PaulBichl/vibepcb-smu/boards/smu-front/hardware/smu-front-bottom.png

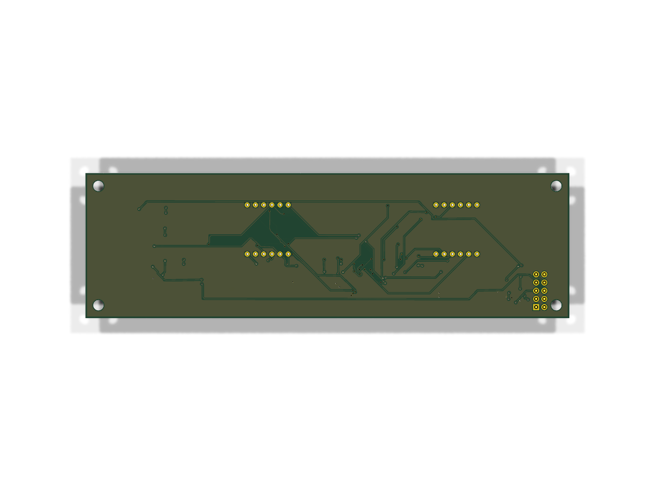
boards/smu-front/hardware/smu-front-bottom.png
