PaulBichl/vibepcb-smu/boards/smu-front/hardware/smu-front-layout-back.png

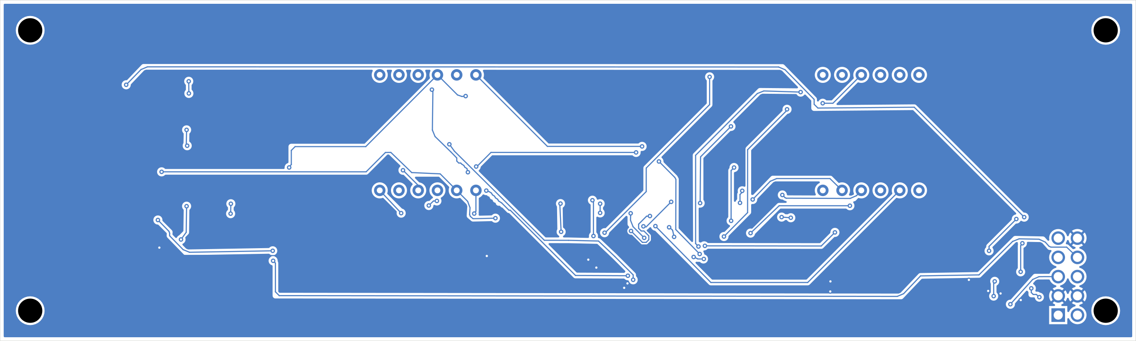
boards/smu-front/hardware/smu-front-layout-back.png
