PaulBichl/vibepcb-smu/boards/smu-front/hardware/smu-front-layout-front.png

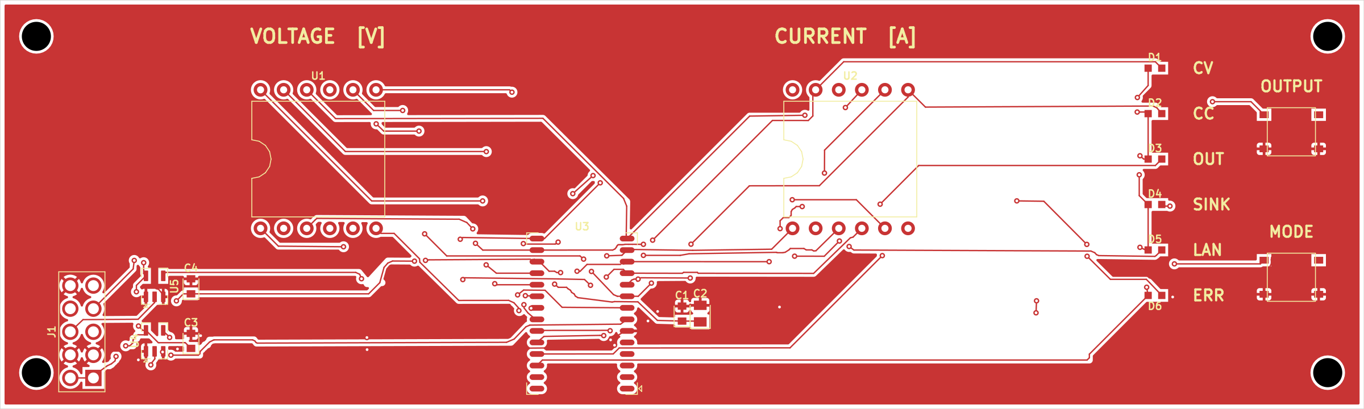
boards/smu-front/hardware/smu-front-layout-front.png
