PaulBichl/vibepcb-smu/boards/smu-main/hardware/smu-main-bottom.png

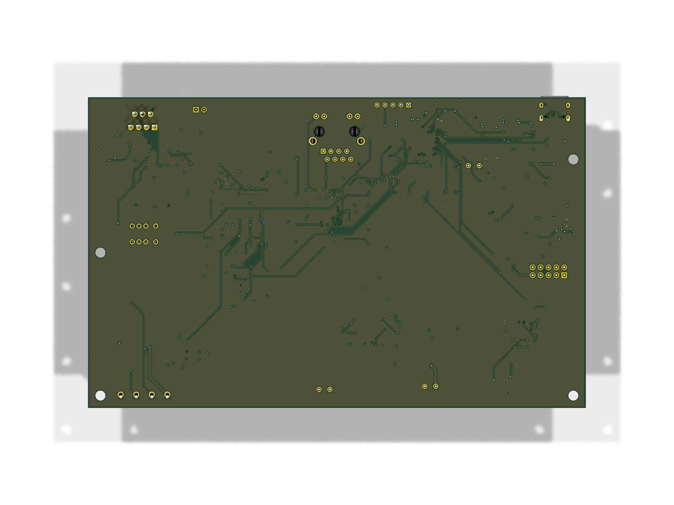
boards/smu-main/hardware/smu-main-bottom.png
