PaulBichl/vibepcb-smu/boards/smu-main/hardware/smu-main-layout-back.png

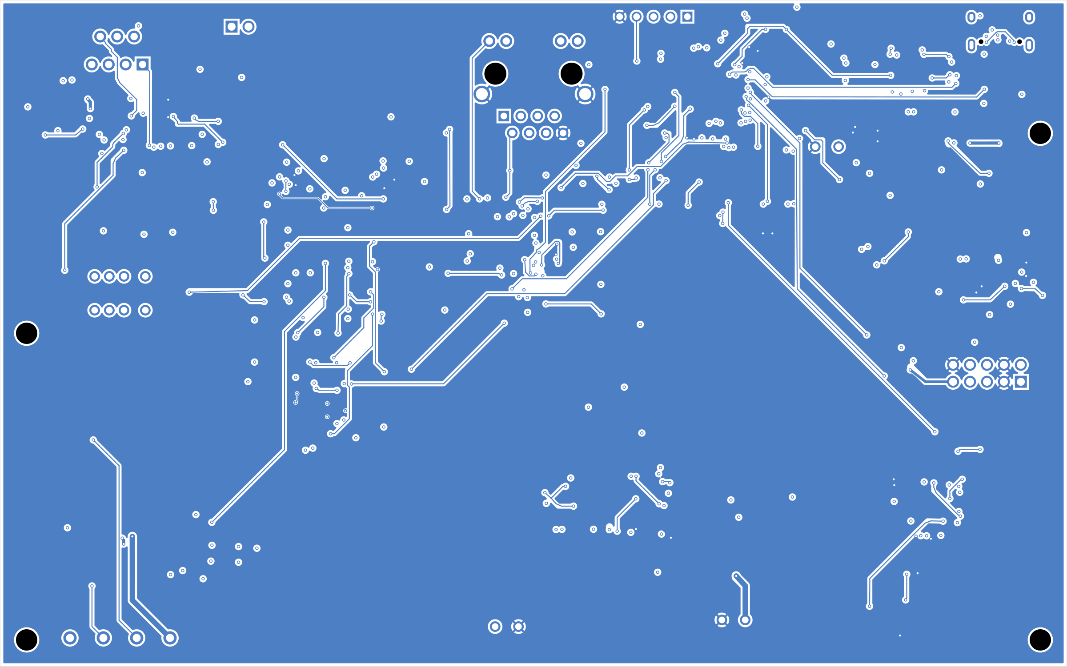
boards/smu-main/hardware/smu-main-layout-back.png
