PaulBichl/vibepcb-smu/boards/smu-main/hardware/smu-main-layout-front.png

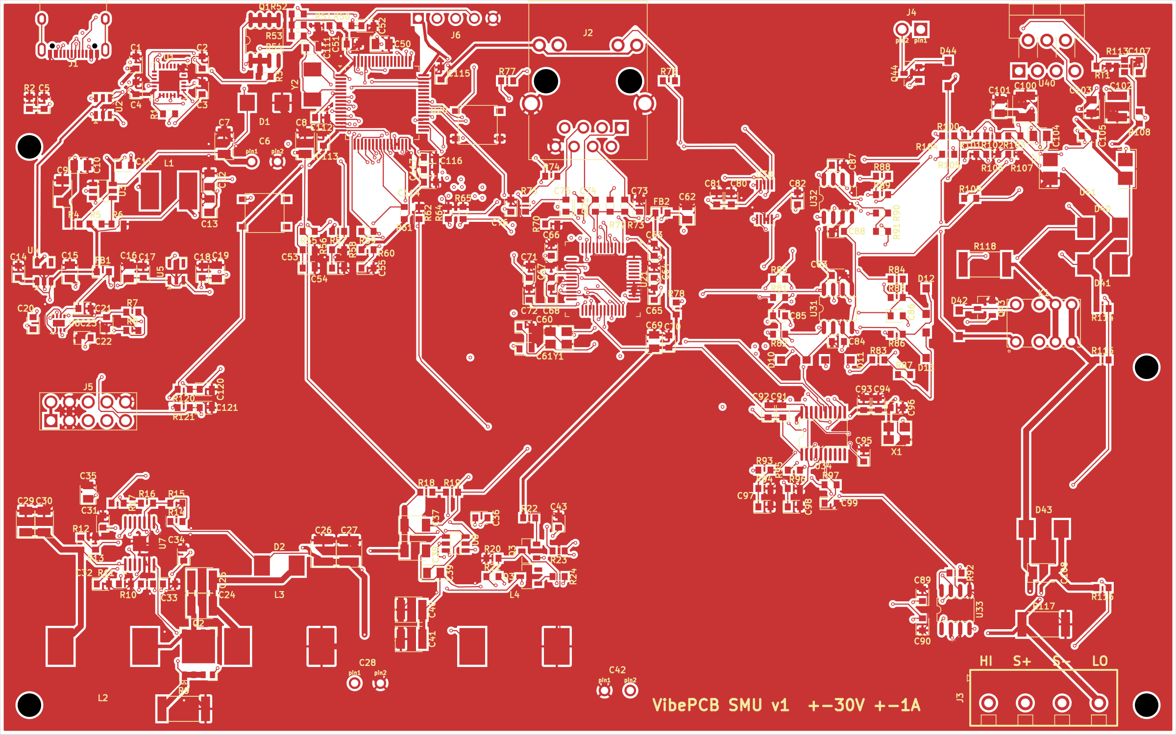
boards/smu-main/hardware/smu-main-layout-front.png
