PaulBichl/vibepcb-smu/boards/smu-front/hardware/smu-front-bom.csv

Qty | Designator | Value | Footprint | MPN | LCSC Part #
3 | C1,C3,C4 | 100nF | tscircuit:capacitor_cap0603 |  | C14663
1 | C2 | 10uF | tscircuit:capacitor_cap0805 |  | C15850
3 | D1,D3,D5 | KT-0603G | tscircuit:KT-0603G | KT-0603G | C12624
3 | D2,D4,D6 | KT-0603R | tscircuit:KT-0603R | KT-0603R | C2286
1 | J1 | A2541WV-2x5P | tscircuit:A2541WV-2x5P | A2541WV-2x5P | C225520
2 | SW1,SW2 | TS-1187A-B-A-B | tscircuit:TS-1187A-B-A-B | TS-1187A-B-A-B | C318884
2 | U1,U2 | SR420561N | tscircuit:SR420561N | SR420561N | C109200
1 | U3 | TM1640(TA2103) | tscircuit:TM1640_TA2103 | TM1640(TA2103) | C5337152
2 | U4,U5 | SN74LV1T125DBVR | tscircuit:SN74LV1T125DBVR | SN74LV1T125DBVR | C473338
