PaulBichl/vibepcb-smu/boards/smu-main/hardware/smu-main-bom.csv

Qty | Designator | Value | Footprint | MPN | LCSC Part #
12 | C1,C2,C3,C14,C18,C20,C31,C43,C81,C92,C94,C116 | 1uF | tscircuit:capacitor_cap0603 |  | C15849
34 | C4,C11,C17,C36,C51,C52,C53,C54,C55,C63,C64,C65,C66,C67,C68,C70,C80,C82,C83,C84,C87,C88,C89,C90,C91,C93,C96,C107,C113,C114,C115,C117,C120,C121 | 100nF | tscircuit:capacitor_cap0603 |  | C14663
1 | C5 | 4.7nF | tscircuit:capacitor_cap0603 |  | C53987
3 | C6,C28,C42 | 100uF | tscircuit:NXA63V100M8_15_LO | NXA63V100M8*15 LO | C3002361
7 | C7,C8,C9,C29,C30,C37,C38 | 2.2uF | tscircuit:capacitor_cap1206 |  | C170101
4 | C10,C39,C101,C103 | 100nF | tscircuit:capacitor_cap0805 |  | C28233
2 | C12,C13 | 22uF | tscircuit:capacitor_cap0805 |  | C45783
7 | C15,C16,C19,C35,C50,C62,C69 | 10uF | tscircuit:capacitor_cap0805 |  | C15850
4 | C21,C22,C23,C71 | 4.7uF | tscircuit:capacitor_cap0603 |  | C19666
8 | C24,C25,C26,C27,C40,C41,C100,C102 | 4.7uF | tscircuit:capacitor_cap1210 |  | C337978
3 | C32,C85,C86 | 47nF | tscircuit:capacitor_cap0603 |  | C107093
2 | C33,C73 | 22nF | tscircuit:capacitor_cap0603 |  | C21122
1 | C34 | 470pF | tscircuit:capacitor_cap0603 |  | C1620
2 | C60,C61 | 15pF | tscircuit:capacitor_cap0603 |  | C1644
3 | C72,C76,C99 | 10nF | tscircuit:capacitor_cap0603 |  | C57112
2 | C74,C75 | 6.8nF | tscircuit:capacitor_cap0603 |  | C1631
1 | C95 | 220nF | tscircuit:capacitor_cap0603 |  | C21120
3 | C97,C98,C105 | 1nF | tscircuit:capacitor_cap0603 |  | C1588
1 | C104 | 4.7nF | tscircuit:capacitor_cap0805 |  | C107104
1 | C108 | 1uF | tscircuit:capacitor_cap1206 |  | C13832
2 | C111,C112 | 22pF | tscircuit:capacitor_cap0603 |  | C1653
1 | D1 | SMBJ24A | tscircuit:SMBJ24A | SMBJ24A | C123819
3 | D2,D40,D41 | SS5100 | tscircuit:SS5100 | SS5100 | C5128814
1 | D3 | BZX84C51 | tscircuit:BZX84C51 | BZX84C51 | C213380
6 | D10,D11,D12,D13,D42,D44 | 1N4148W | tscircuit:1N4148W | 1N4148W | C81598
1 | D43 | SMBJ36CA | tscircuit:SMBJ36CA | SMBJ36CA | C114002
2 | FB1,FB2 | 1µH | tscircuit:BLM18PG221SN1D | BLM18PG221SN1D | C80165
1 | J1 | TYPE-C 16PIN 2MD(073) | tscircuit:TYPE-C_16PIN_2MD_073 | TYPE-C 16PIN 2MD(073) | C2765186
1 | J2 | HR911105A | tscircuit:HR911105A | HR911105A | C12074
1 | J3 | DG301-5.0-04P-14-1000A(H) | tscircuit:DG301-5_0-04P-14-1000A_H | DG301-5.0-04P-14-1000A(H) | C3037697
1 | J4 | B2B-XH-A-GU | tscircuit:B2B-XH-A-GU | B2B-XH-A-GU | C265283
1 | J5 | A2541WV-2x5P | tscircuit:A2541WV-2x5P | A2541WV-2x5P | C225520
1 | J6 | PZ254V-11-05P | tscircuit:PZ254V-11-05P | PZ254V-11-05P | C492404
1 | K1 | HFD4/5 | tscircuit:HFD4_5 | HFD4/5 | C23510
1 | L1 | 10µH | tscircuit:SWPA6045S100MT | SWPA6045S100MT | C79272
3 | L2,L3,L4 | 22µH | tscircuit:SRP1265A-220M | SRP1265A-220M | C2041465
1 | Q1 | AO4407A | tscircuit:AO4407A | AO4407A | C2841482
1 | Q2 | BSC160N10NS3G | tscircuit:BSC160N10NS3G | BSC160N10NS3G | C148261
1 | Q3 | MMBT5401(RANGE:200-300) | tscircuit:MMBT5401_RANGE_200-300 | MMBT5401(RANGE:200-300) | C8326
2 | Q43,Q44 | AO3400A | tscircuit:AO3400A | AO3400A | C20917
4 | R1,R17,R24,R97 | 1kΩ | tscircuit:resistor_res0603 |  | C21190
3 | R2,R7,R18 | 1MΩ | tscircuit:resistor_res0603 |  | C22935
10 | R3,R4,R5,R14,R19,R20,R55,R62,R64,R65 | 100kΩ | tscircuit:resistor_res0603 |  | C25803
3 | R6,R81,R85 | 20kΩ | tscircuit:resistor_res0603 |  | C4184
1 | R8 | 390kΩ | tscircuit:resistor_res0603 |  | C23150
1 | R9 | 15mΩ | tscircuit:resistor_res2512 |  | C154674
21 | R10,R13,R16,R23,R50,R51,R54,R56,R58,R60,R61,R78,R80,R83,R84,R87,R90,R91,R113,R120,R121 | 10kΩ | tscircuit:resistor_res0603 |  | C25804
2 | R11,R109 | 49.9kΩ | tscircuit:resistor_res0603 |  | C23184
1 | R12 | 75kΩ | tscircuit:resistor_res0603 |  | C23242
1 | R15 | 4.3kΩ | tscircuit:resistor_res0603 |  | C23159
1 | R21 | 2.4kΩ | tscircuit:resistor_res0603 |  | C22940
1 | R22 | 9.1kΩ | tscircuit:resistor_res0603 |  | C23260
3 | R52,R53,R114 | 4.7kΩ | tscircuit:resistor_res0603 |  | C23162
1 | R57 | 150kΩ | tscircuit:resistor_res0603 |  | C22807
1 | R59 | 120kΩ | tscircuit:resistor_res0603 |  | C25808
1 | R70 | 12.4kΩ | tscircuit:resistor_res0603 |  | C2930060
4 | R71,R72,R74,R75 | 49.9Ω | tscircuit:resistor_res0603 |  | C23185
1 | R73 | 10Ω | tscircuit:resistor_res0603 |  | C22859
2 | R76,R77 | 330Ω | tscircuit:resistor_res0603 |  | C23138
2 | R82,R86 | 12kΩ | tscircuit:resistor_res0603 |  | C22790
10 | R88,R89,R94,R96,R100,R101,R102,R105,R106,R107 | 10kΩ | tscircuit:resistor_res0603 |  | C95204
1 | R92 | 5.6kΩ | tscircuit:resistor_res0603 |  | C179095
2 | R93,R95 | 300kΩ | tscircuit:resistor_res0603 |  | C335091
2 | R103,R104 | 120kΩ | tscircuit:resistor_res0603 |  | C351687
1 | R108 | 680Ω | tscircuit:resistor_res0603 |  | C23228
2 | R115,R116 | 100Ω | tscircuit:resistor_res0603 |  | C22775
1 | R117 | 100mΩ | tscircuit:resistor_res2512 |  | C500724
1 | R118 | 470mΩ | tscircuit:HoJLR2512-2W-470mR-1_-75ppm | HoJLR2512-2W-470mR-1%-75ppm | C2924582
1 | RT1 | 10kΩ | tscircuit:NCP18XH103F03RB | NCP18XH103F03RB | C13564
2 | SW1,SW2 | TS-1187A-B-A-B | tscircuit:TS-1187A-B-A-B | TS-1187A-B-A-B | C318884
1 | U1 | STUSB4500QTR | tscircuit:STUSB4500QTR | STUSB4500QTR | C2678061
1 | U2 | USBLC6-2SC6 | tscircuit:USBLC6-2SC6 | USBLC6-2SC6 | C2687116
2 | U3,U8 | LMR51635YDDCR | tscircuit:LMR51635YDDCR | LMR51635YDDCR | C45262770
1 | U4 | AP2112K-3.3TRG1 | tscircuit:AP2112K-3_3TRG1 | AP2112K-3.3TRG1 | C51118
1 | U5 | ME6211C33M5G-N | tscircuit:ME6211C33M5G-N | ME6211C33M5G-N | C82942
1 | U6 | LM27761DSGR | tscircuit:LM27761DSGR | LM27761DSGR | C129351
1 | U7 | LM5156HPWPR | tscircuit:LM5156HPWPR | LM5156HPWPR | C2867852
1 | U20 | STM32G431RBT6 | tscircuit:STM32G431RBT6 | STM32G431RBT6 | C431633
1 | U21 | W5500 | tscircuit:W5500 | W5500 | C32843
1 | U30 | DAC8563SDGSR | tscircuit:DAC8563SDGSR | DAC8563SDGSR | C1554729
2 | U31,U32 | OPA2192IDR | tscircuit:OPA2192IDR | OPA2192IDR | C110074
1 | U33 | INA828IDR | tscircuit:INA828IDR | INA828IDR | C544342
1 | U34 | ADS131M02IPWR | tscircuit:ADS131M02IPWR | ADS131M02IPWR | C2922448
1 | U40 | OPA548T | tscircuit:OPA548T | OPA548T | C138712
1 | U41 | PC817C | tscircuit:PC817C | PC817C | C22447129
1 | X1 | OT2JI-111-8.192M | tscircuit:OT2JI-111-8_192M | OT2JI-111-8.192M | C7425393
1 | Y1 | NX3225SA-25MHz-STD-CSR-6 | tscircuit:NX3225SA-25MHz-STD-CSR-6 | NX3225SA-25MHz-STD-CSR-6 | C448646
1 | Y2 | X50328MSB2GI | tscircuit:X50328MSB2GI | X50328MSB2GI | C115962
