PaulBichl/vibepcb-smu/boards/smu-front/hardware/smu-front-schematic.pdf

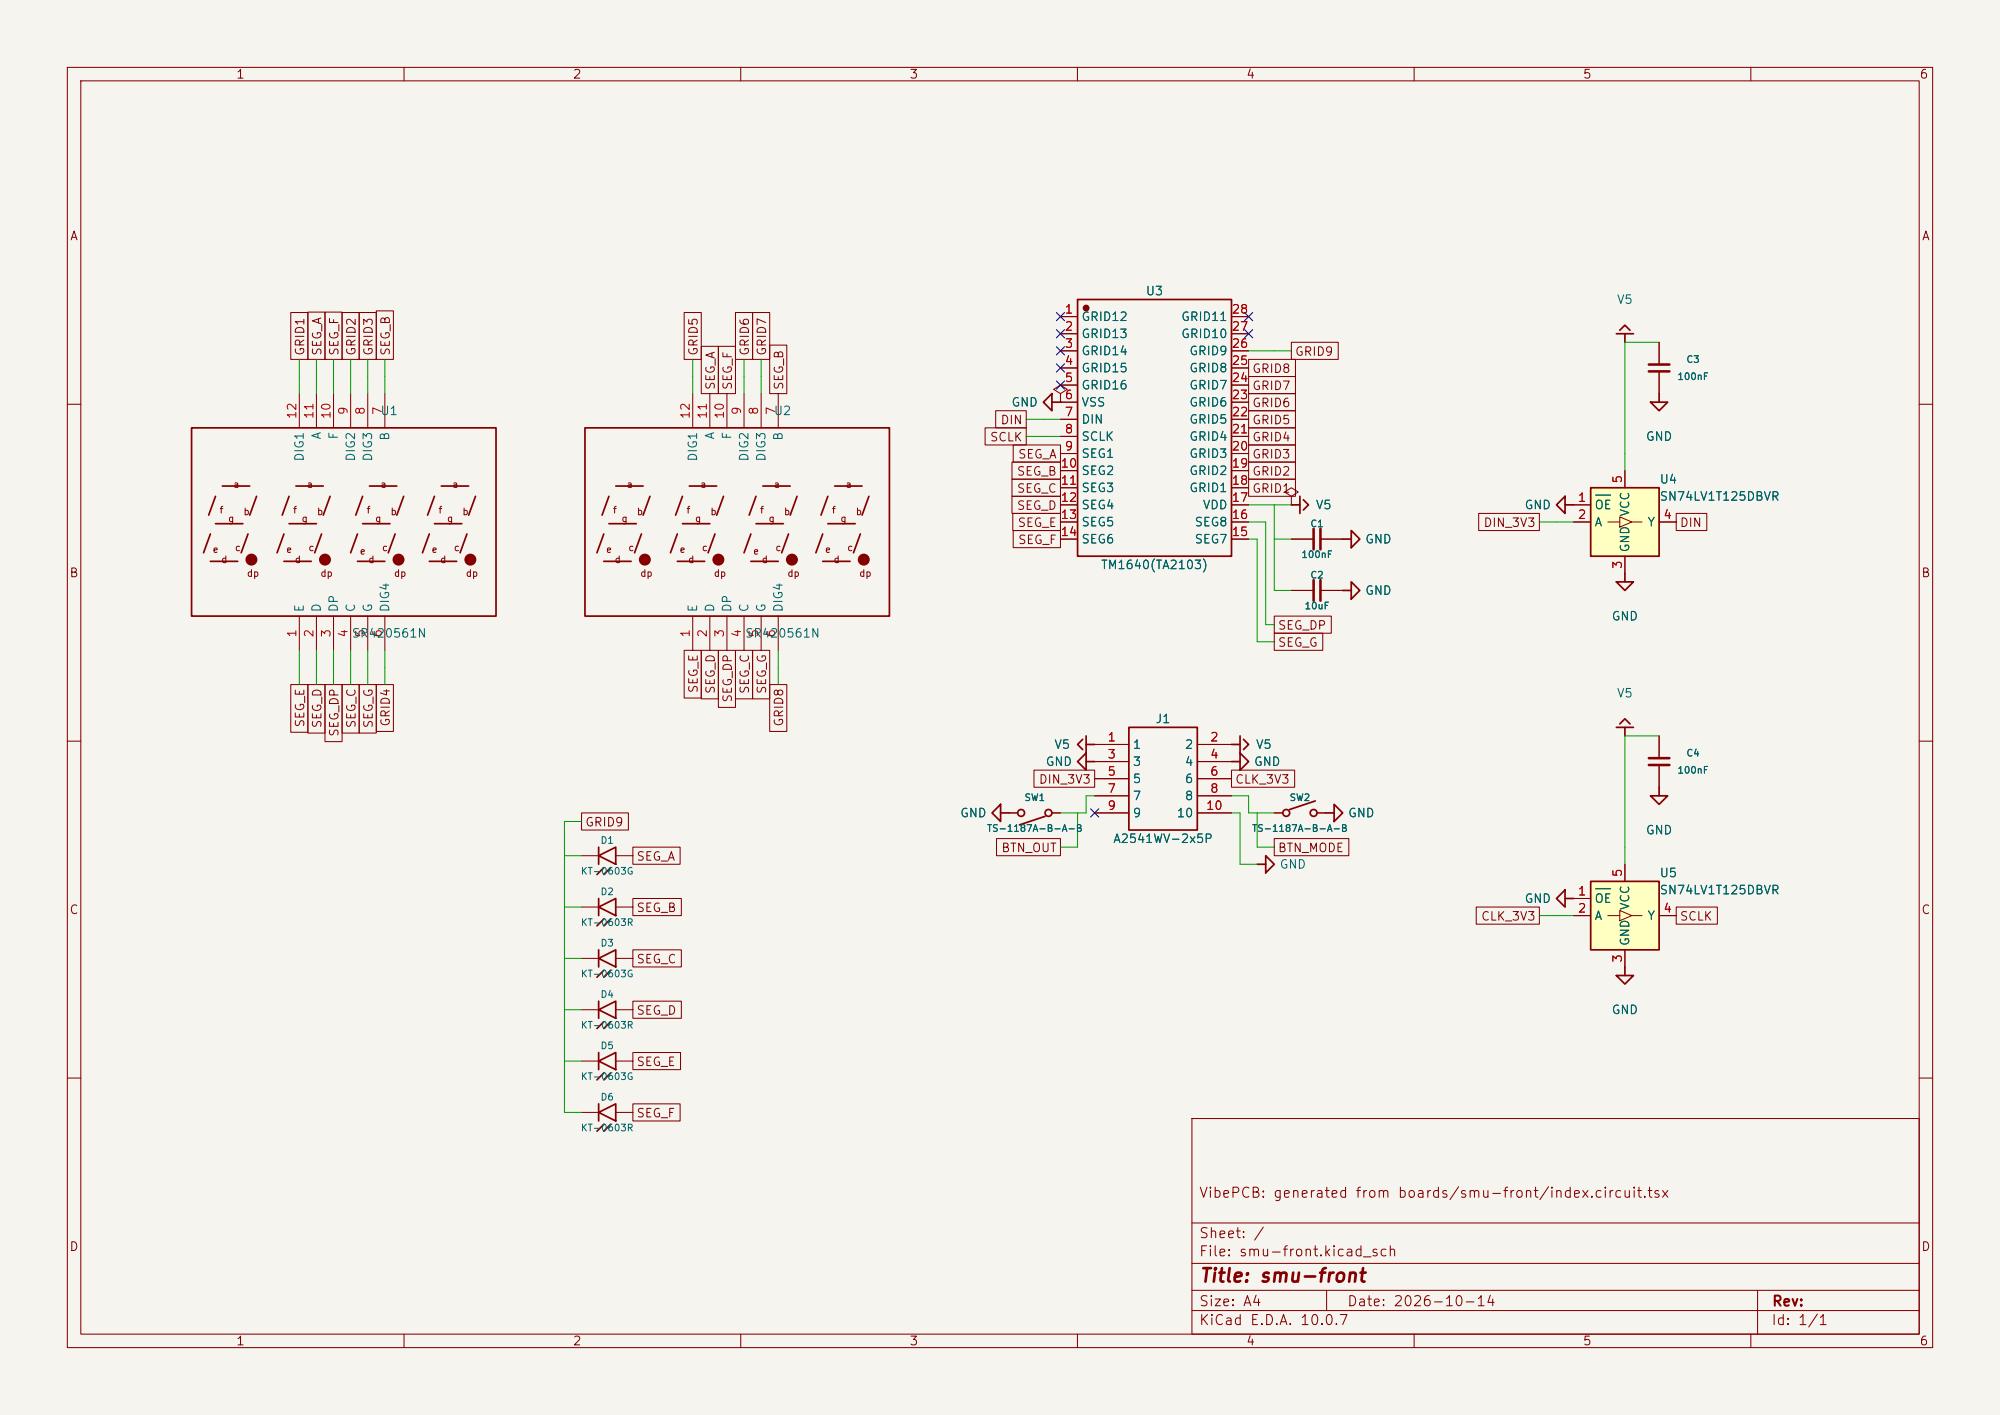
[picture p9: page 1]

VibePCB: generated from boards/smu-front/index.circuit.tsx

Size: A4 | Rev:
KiCad E.D.A. 10.0.7 | Id: 1/1
