PaulBichl/vibepcb-smu/boards/smu-main/hardware/smu-main-schematic.pdf

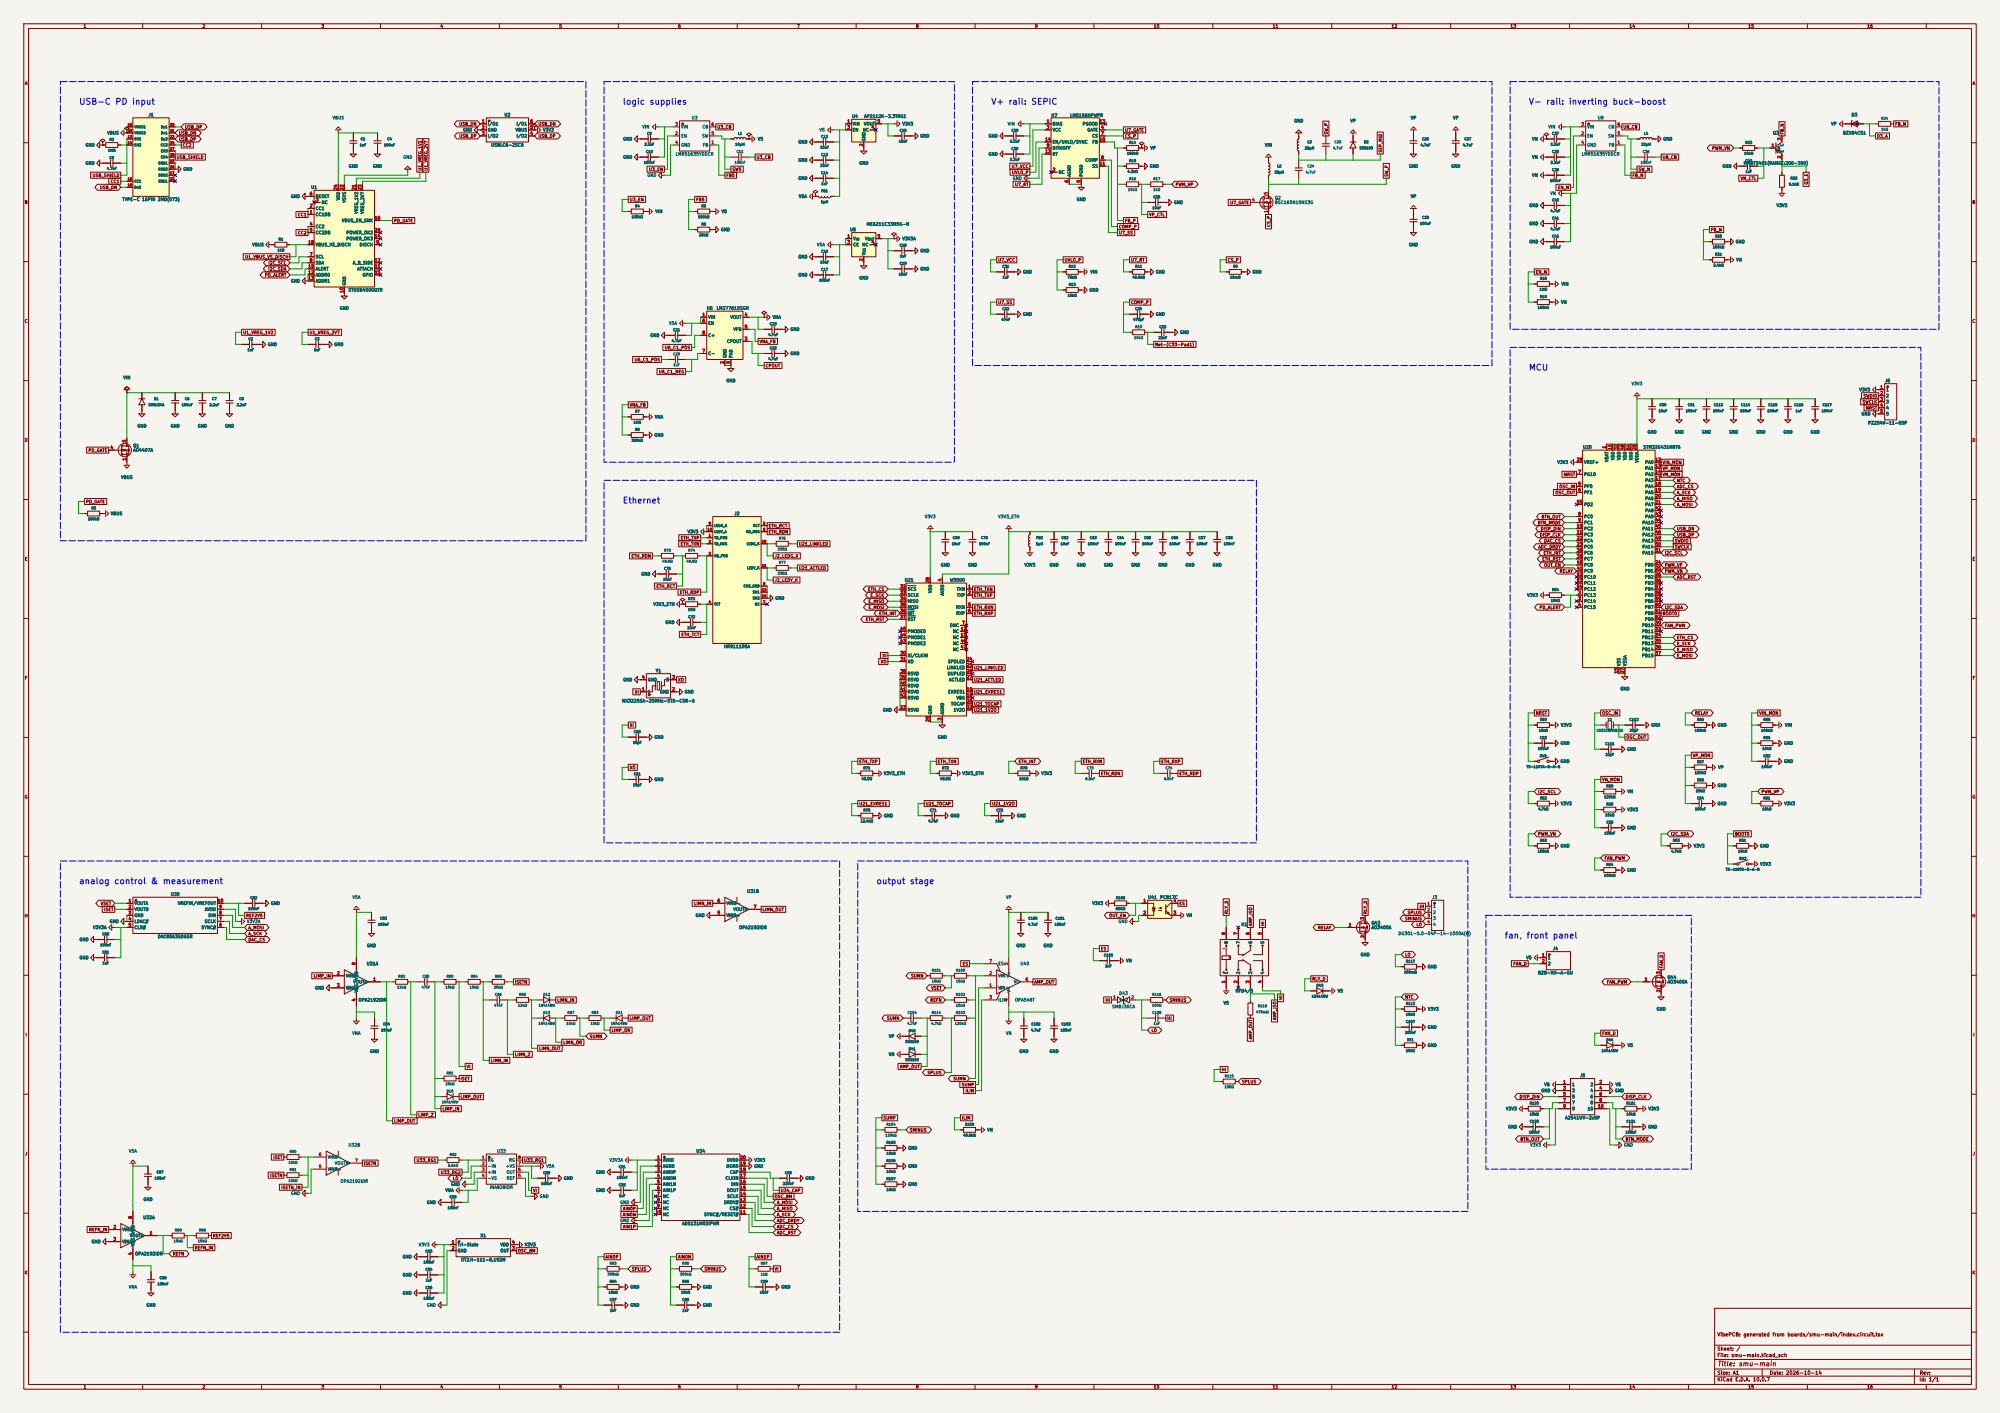
[picture p10: page 1]

VibePCB: generated from boards/smu-main/index.circuit.tsx

Size: A1 | Rev:
KiCad E.D.A. 10.0.7 | Id: 1/1
