PaulBichl/vibepcb-smu/boards/smu-front/hardware/smu-front-layout.pdf

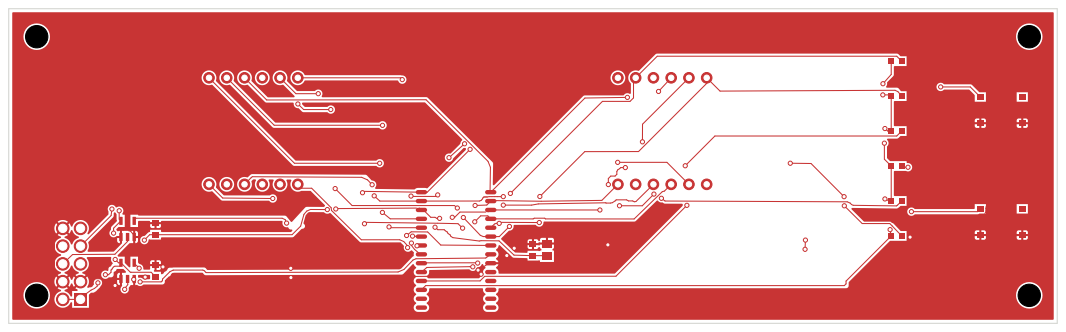
[picture p11: page 1]

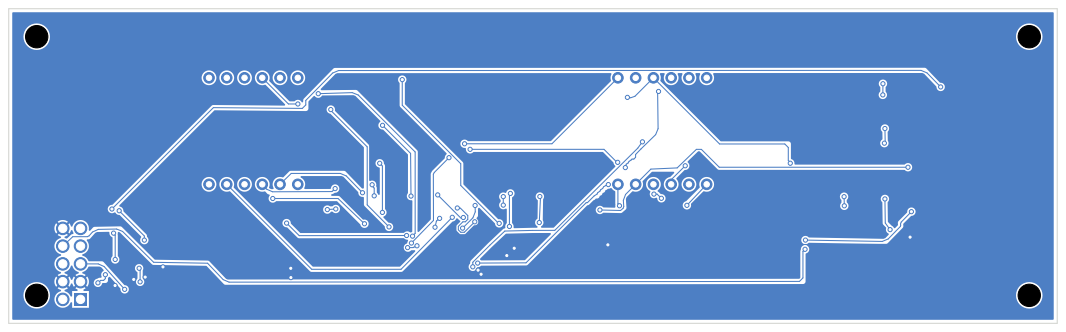
[picture p12: page 2]
