PaulBichl/vibepcb-smu/boards/smu-main/hardware/kicad/smu-main.kicad_pcb

## KiCad design boards/smu-main/hardware/kicad/smu-main.kicad_pcb (2026-10-14)

Schematic: smu-main.kicad_sch

Parts:
C1, C2, C3, C14, C18, C20, C31, C43, C81, C92, C94, C116: 1uF; capacitor_cap0603; LCSC C15849
C4, C11, C17, C36, C51, C52, C53, C54, C55, C63, C64, C65, C66, C67, C68, C70, C80, C82, C83, C84, C87, C88, C89, C90, C91, C93, C96, C107, C113, C114, C115, C117, C120, C121: 100nF; capacitor_cap0603; LCSC C14663
C5: 4.7nF; capacitor_cap0603; LCSC C53987
C6, C28, C42: 100uF; NXA63V100M8_15_LO; MPN NXA63V100M8*15 LO; LCSC C3002361
C7, C8, C9, C29, C30, C37, C38: 2.2uF; capacitor_cap1206; LCSC C170101
C10, C39, C101, C103: 100nF; capacitor_cap0805; LCSC C28233
C12, C13: 22uF; capacitor_cap0805; LCSC C45783
C15, C16, C19, C35, C50, C62, C69: 10uF; capacitor_cap0805; LCSC C15850
C21, C22, C23, C71: 4.7uF; capacitor_cap0603; LCSC C19666
C24, C25, C26, C27, C40, C41, C100, C102: 4.7uF; capacitor_cap1210; LCSC C337978
C32, C85, C86: 47nF; capacitor_cap0603; LCSC C107093
C33, C73: 22nF; capacitor_cap0603; LCSC C21122
C34: 470pF; capacitor_cap0603; LCSC C1620
C60, C61: 15pF; capacitor_cap0603; LCSC C1644
C72, C76, C99: 10nF; capacitor_cap0603; LCSC C57112
C74, C75: 6.8nF; capacitor_cap0603; LCSC C1631
C95: 220nF; capacitor_cap0603; LCSC C21120
C97, C98, C105: 1nF; capacitor_cap0603; LCSC C1588
C104: 4.7nF; capacitor_cap0805; LCSC C107104
C108: 1uF; capacitor_cap1206; LCSC C13832
C111, C112: 22pF; capacitor_cap0603; LCSC C1653
D1: SMBJ24A; MPN SMBJ24A; LCSC C123819
D2, D40, D41: SS5100; MPN SS5100; LCSC C5128814
D3: BZX84C51; MPN BZX84C51; LCSC C213380
D10, D11, D12, D13, D42, D44: 1N4148W; MPN 1N4148W; LCSC C81598
D43: SMBJ36CA; MPN SMBJ36CA; LCSC C114002
FB1, FB2: 1µH; BLM18PG221SN1D; MPN BLM18PG221SN1D; LCSC C80165
J1: TYPE-C 16PIN 2MD(073); TYPE-C_16PIN_2MD_073; MPN TYPE-C 16PIN 2MD(073); LCSC C2765186
J2: HR911105A; MPN HR911105A; LCSC C12074
J3: DG301-5.0-04P-14-1000A(H); DG301-5_0-04P-14-1000A_H; MPN DG301-5.0-04P-14-1000A(H); LCSC C3037697
J4: B2B-XH-A-GU; MPN B2B-XH-A-GU; LCSC C265283
J5: A2541WV-2x5P; MPN A2541WV-2x5P; LCSC C225520
J6: PZ254V-11-05P; MPN PZ254V-11-05P; LCSC C492404
K1: HFD4/5; HFD4_5; MPN HFD4/5; LCSC C23510
L1: 10µH; SWPA6045S100MT; MPN SWPA6045S100MT; LCSC C79272
L2, L3, L4: 22µH; SRP1265A-220M; MPN SRP1265A-220M; LCSC C2041465
Q1: AO4407A; MPN AO4407A; LCSC C2841482
Q2: BSC160N10NS3G; MPN BSC160N10NS3G; LCSC C148261
Q3: MMBT5401(RANGE:200-300); MMBT5401_RANGE_200-300; MPN MMBT5401(RANGE:200-300); LCSC C8326
Q43, Q44: AO3400A; MPN AO3400A; LCSC C20917
R1, R17, R24, R97: 1kΩ; resistor_res0603; LCSC C21190
R2, R7, R18: 1MΩ; resistor_res0603; LCSC C22935
R3, R4, R5, R14, R19, R20, R55, R62, R64, R65: 100kΩ; resistor_res0603; LCSC C25803
R6, R81, R85: 20kΩ; resistor_res0603; LCSC C4184
R8: 390kΩ; resistor_res0603; LCSC C23150
R9: 15mΩ; resistor_res2512; LCSC C154674
R10, R13, R16, R23, R50, R51, R54, R56, R58, R60, R61, R78, R80, R83, R84, R87, R90, R91, R113, R120, R121: 10kΩ; resistor_res0603; LCSC C25804
R11, R109: 49.9kΩ; resistor_res0603; LCSC C23184
R12: 75kΩ; resistor_res0603; LCSC C23242
R15: 4.3kΩ; resistor_res0603; LCSC C23159
R21: 2.4kΩ; resistor_res0603; LCSC C22940
R22: 9.1kΩ; resistor_res0603; LCSC C23260
R52, R53, R114: 4.7kΩ; resistor_res0603; LCSC C23162
R57: 150kΩ; resistor_res0603; LCSC C22807
R59: 120kΩ; resistor_res0603; LCSC C25808
R70: 12.4kΩ; resistor_res0603; LCSC C2930060
R71, R72, R74, R75: 49.9Ω; resistor_res0603; LCSC C23185
R73: 10Ω; resistor_res0603; LCSC C22859
R76, R77: 330Ω; resistor_res0603; LCSC C23138
R82, R86: 12kΩ; resistor_res0603; LCSC C22790
R88, R89, R94, R96, R100, R101, R102, R105, R106, R107: 10kΩ; resistor_res0603; LCSC C95204
R92: 5.6kΩ; resistor_res0603; LCSC C179095
R93, R95: 300kΩ; resistor_res0603; LCSC C335091
R103, R104: 120kΩ; resistor_res0603; LCSC C351687
R108: 680Ω; resistor_res0603; LCSC C23228
R115, R116: 100Ω; resistor_res0603; LCSC C22775
R117: 100mΩ; resistor_res2512; LCSC C500724
R118: 470mΩ; HoJLR2512-2W-470mR-1_-75ppm; MPN HoJLR2512-2W-470mR-1%-75ppm; LCSC C2924582
RT1: 10kΩ; NCP18XH103F03RB; MPN NCP18XH103F03RB; LCSC C13564
SW1, SW2: TS-1187A-B-A-B; MPN TS-1187A-B-A-B; LCSC C318884
U1: STUSB4500QTR; MPN STUSB4500QTR; LCSC C2678061
U2: USBLC6-2SC6; MPN USBLC6-2SC6; LCSC C2687116
U3, U8: LMR51635YDDCR; MPN LMR51635YDDCR; LCSC C45262770
U4: AP2112K-3.3TRG1; AP2112K-3_3TRG1; MPN AP2112K-3.3TRG1; LCSC C51118
U5: ME6211C33M5G-N; MPN ME6211C33M5G-N; LCSC C82942
U6: LM27761DSGR; MPN LM27761DSGR; LCSC C129351
U7: LM5156HPWPR; MPN LM5156HPWPR; LCSC C2867852
U20: STM32G431RBT6; MPN STM32G431RBT6; LCSC C431633
U21: W5500; MPN W5500; LCSC C32843
U30: DAC8563SDGSR; MPN DAC8563SDGSR; LCSC C1554729
U31, U32: OPA2192IDR; MPN OPA2192IDR; LCSC C110074
U33: INA828IDR; MPN INA828IDR; LCSC C544342
U34: ADS131M02IPWR; MPN ADS131M02IPWR; LCSC C2922448
U40: OPA548T; MPN OPA548T; LCSC C138712
U41: PC817C; MPN PC817C; LCSC C22447129
X1: OT2JI-111-8.192M; OT2JI-111-8_192M; MPN OT2JI-111-8.192M; LCSC C7425393
Y1: NX3225SA-25MHz-STD-CSR-6; MPN NX3225SA-25MHz-STD-CSR-6; LCSC C448646
Y2: X50328MSB2GI; MPN X50328MSB2GI; LCSC C115962

Connections:
ADC_CS: U20.18 (PA4), U34.12 (CS#)
ADC_DRDY: U20.23 (PC5), U34.13 (DRDY#)
ADC_RST: U20.26 (PB2), U34.11 (SYNC#/RESET#)
AIN0N: C98.1, R95.2, R96.1, U34.4 (AIN0N)
AIN0P: C97.1, R93.2, R94.1, U34.3 (AIN0P)
AIN1P: C99.1, R97.2, U34.6 (AIN1P)
AMP_ISO: K1.3, K1.6, R118.2
AMP_OUT: C104.1, D40.2 (anode), D41.1 (cathode), R114.1, R118.1, U40.6 (VO)
A_MISO: U20.20 (PA6), U34.15 (DOUT)
A_MOSI: U20.21 (PA7), U30.8 (DIN), U34.16 (DIN)
A_SCK: U20.19 (PA5), U30.7 (SCLK), U34.14 (SCLK)
BOOT0: R51.2, SW2.1 (AB), U20.61 (PB8)
BTN_MODE: C121.1, J5.8, R121.2, U20.9 (PC1)
BTN_OUT: C120.1, J5.7, R120.2, U20.8 (PC0)
CC1: J1.18 (CC1), U1.1 (CC1DB), U1.2 (CC1)
CC2: J1.24 (CC2), U1.4 (CC2), U1.5 (CC2DB)
COMP_P: C34.1, R10.1, U7.8 (COMP)
CPOUT: C22.2, U6.3 (CPOUT)
CS_P: Q2.1 (S), Q2.2 (S), Q2.3 (S), R9.1, U7.7 (CS)
D3_A: D3.1 (A), R24.1
DAC_CS: U20.22 (PC4), U30.6 (SYNC#)
DISP_CLK: J5.6, U20.11 (PC3)
DISP_DIN: J5.5, U20.10 (PC2)
EN_N: R18.2, R19.1, U8.2 (EN)
ES: C105.1, U40.7 (ES), U41.4
ETH_CS: U20.34 (PB12), U21.32 (~SCS)
ETH_INT: R78.2, U20.38 (PC6), U21.36 (~INT)
ETH_RCT: C76.1, J2.5 (RCT), R74.2, R75.2
ETH_RDN: C75.2, J2.6 (RD_NEG), R75.1
ETH_RDP: C74.2, J2.3 (RD_POS), R74.1
ETH_RST: U20.39 (PC7), U21.37 (~RST)
ETH_RXN: C75.1, U21.5 (RXN)
ETH_RXP: C74.1, U21.6 (RXP)
ETH_TCT: C73.1, J2.4 (TCT), R73.2
ETH_TXN: J2.2 (TD_NEG), R72.2, U21.1 (TXN)
ETH_TXP: J2.1 (TD_POS), R71.2, U21.2 (TXP)
E_MISO: U20.36 (PB14), U21.34 (MISO)
E_MOSI: U20.37 (PB15), U21.35 (MOSI)
E_SCK: U20.35 (PB13), U21.33 (SCLK)
FAN_D: D44.2 (anode), J4.2, Q44.3 (D)
FAN_PWM: Q44.1 (G), R64.1, U20.30 (PB10)
FB5: R5.2, R6.1, U3.1 (FB)
FB_N: Q3.3 (C), R20.2, R21.1, R24.2, U8.1 (FB)
FB_P: R14.2, R15.1, R16.2, U7.10 (FB)
GND: C1.2, C2.2, C3.2, C4.2, C5.2, C6.2, C7.2, C8.2, C9.2, C10.2, C12.2, C13.2, C14.2, C15.2, C16.2, C17.2, C18.2, C19.2, C21.2, C22.1, C23.1, C26.2, C27.2, C28.2, C29.2, C30.2, C31.2, C32.2, C33.2, C34.2, C35.2, C40.1, C41.1, C42.1, C43.2, C50.2, C51.2, C52.2, C53.2, C54.2, C55.2, C60.2, C61.2, C62.2, C63.2, C64.2, C65.2, C66.2, C67.2, C68.2, C69.2, C70.2, C71.2, C72.2, C73.2, C76.2, C80.2, C81.2, C82.2, C83.2, C84.1, C87.2, C88.1, C89.2, C90.1, C91.2, C92.2, C93.2, C94.2, C95.2, C96.2, C97.2, C98.2, C99.2, C100.2, C101.2, C102.1, C103.1, C107.2, C111.2, C112.2, C113.2, C114.2, C115.2, C116.2, C117.2, C120.2, C121.2, D1.2 (A), J1.15 (GND1), J1.26 (GND2), J2.8 (CHS_GND), J2.13 (SH1), J2.14 (SH2), J5.3, J5.4, J5.10, J6.5, L3.2, L4.2, Q43.2 (S), Q44.2 (S), R2.2, R6.2, R8.2, R9.2, R11.2, R13.2, R15.2, R20.1, R51.1, R56.2, R58.2, R62.2, R64.2, R65.2, R70.2, R94.2, R96.2, R105.2, R106.2, R107.2, R117.2, RT1.2, SW1.2 (CD), U1.6 (RESET), U1.10 (GND), U1.12 (ADDR0), U1.13 (ADDR1), U1.22 (VSYS), U1.25 (GND), U2.2 (GND), U3.4 (GND), U4.2 (GND), U5.2 (V_{SS}), U6.2 (GND), U6.9 (PAD), U7.5 (PGND), U7.6 (AGND), U7.9 (DITHOFF), U7.15 (AGND), U20.15 (VSS), U20.27 (VSSA), U20.31 (VSS), U20.47 (VSS), U20.63 (VSS), U21.3 (AGND), U21.9 (AGND), U21.14 (AGND), U21.16 (AGND), U21.19 (AGND), U21.23 (RSVD), U21.29 (GND), U21.38 (RSVD), U21.39 (RSVD), U21.40 (RSVD), U21.41 (RSVD), U21.42 (RSVD), U21.48 (AGND), U30.3 (GND), U30.4 (LDAC#), U31.3 (VINA+), U31.5 (VINB+), U32.3 (VINA+), U32.5 (VINB+), U33.3 (+IN), U33.5 (REF), U34.2 (AGND), U34.5 (AIN1N), U34.19 (DGND), U41.2, X1.2 (GND), Y1.2 (GND), Y1.4 (GND)
HI: C108.1, D43.1, J3.1, K1.4, K1.5, R115.1
I2C_SCL: R52.2, U1.7 (SCL), U20.51 (PA15)
I2C_SDA: R53.2, U1.8 (SDA), U20.60 (PB7)
ILIM: R109.1, U40.3 (ILIM)
ISET: R81.1, R90.1, U30.2 (VOUTB)
ISETN: R85.1, R91.2, U32.7 (VOUTB)
ISETN_IN: R90.2, R91.1, U32.6 (VINB-)
J2_LEDG_K: J2.10 (LEDG_K), R76.2
J2_LEDY_K: J2.11 (LEDY_K), R77.2
LIMN_IN: C86.1, D12.1 (cathode), R84.2, R85.2, U31.6 (VINB-)
LIMN_OR: D13.2 (anode), R87.1
LIMN_OUT: D12.2 (anode), D13.1 (cathode), R86.2, U31.7 (VOUTB)
LIMN_Z: C86.2, R86.1
LIMP_IN: C85.1, D10.2 (anode), R80.2, R81.2, U31.2 (VINA-)
LIMP_OR: D11.1 (cathode), R83.1
LIMP_OUT: D10.1 (cathode), D11.2 (anode), R82.2, U31.1 (VOUTA)
LIMP_Z: C85.2, R82.1
LO: C108.2, D43.2, J3.4, R116.1, R117.1, U33.2 (-IN)
NRST: C52.1, J6.4, R50.2, SW1.1 (AB), U20.7 (PG10)
NTC: C107.1, R113.2, RT1.1, U20.17 (PA3)
unnamed: C33.1, R10.2
OSC_8M: U34.17 (CLKIN), X1.3 (OUT)
OSC_IN: C111.1, U20.5 (PF0), Y2.1
OSC_OUT: C112.1, U20.6 (PF1), Y2.2
OUT_EN: R108.2, U20.40 (PC8), U41.1
PD_ALERT: R54.2, U1.19 (ALERT), U20.2 (PC13)
PD_GATE: Q1.4 (G), R3.2, U1.16 (VBUS_EN_SNK)
PWM_VN: R23.1, R62.1, U20.25 (PB1)
PWM_VP: R17.1, R61.2, U20.24 (PB0)
Q3_E: Q3.2 (E), R22.2
REF2V5: C82.1, R88.1, U30.10 (VREFIN/VREFOUT)
REFN: R89.2, R102.1, U32.1 (VOUTA)
REFN_IN: R88.2, R89.1, U32.2 (VINA-)
RELAY: Q43.1 (G), R65.1, U20.41 (PC9)
RLY_D: D42.2 (anode), K1.8, Q43.3 (D)
SEP_MID: C24.2, C25.2, D2.2 (anode), L3.1
SMINUS: J3.3, R95.1, R104.1, R116.2
SPLUS: J3.2, R93.1, R103.1, R114.2, R115.2
SUMN: C104.2, R83.2, R87.2, R100.2, R101.2, R102.2, R103.2, U40.2 (VIN-)
SUMP: R104.2, R105.1, R106.1, R107.1, U40.1 (VIN+)
SW5: C11.2, L1.1, U3.5 (SW)
SWCLK: J6.3, U20.50 (PA14)
SWDIO: J6.2, U20.49 (PA13)
SW_N: C36.2, L4.1, U8.5 (SW)
SW_P: C24.1, C25.1, L2.2, Q2.5 (D), Q2.6 (D), Q2.7 (D), Q2.8 (D), Q2.9 (D)
U1_VBUS_VS_DISCH: R1.2, U1.18 (VBUS_VS_DISCH)
U1_VREG_1V2: C2.1, U1.21 (VREG_1V2)
U1_VREG_2V7: C3.1, U1.23 (VREG_2V7)
U3_CB: C11.1, U3.6 (CB)
U3_EN: R4.2, U3.2 (EN)
U6_C1_NEG: C20.2, U6.7 (C-)
U6_C1_POS: C20.1, U6.8 (C+)
U7_GATE: Q2.4 (G), U7.4 (GATE)
U7_RT: R11.1, U7.12 (RT)
U7_SS: C32.1, U7.11 (SS)
U7_VCC: C31.1, U7.3 (VCC)
U8_CB: C36.1, U8.6 (CB)
U21_1V2O: C72.1, U21.22 (1V2O)
U21_ACTLED: R77.1, U21.27 (ACTLED)
U21_EXRES1: R70.1, U21.10 (EXRES1)
U21_LINKLED: R76.1, U21.25 (LINKLED)
U21_TOCAP: C71.1, U21.20 (TOCAP)
U33_RG1: R92.1, U33.8 (RG)
U33_RG2: R92.2, U33.1 (RG)
U34_CAP: C95.1, U34.18 (CAP)
USB_DN: J1.19 (Dn2), J1.21 (Dn1), U2.1 (I/O1), U2.6 (I/O1), U20.45 (PA11)
USB_DP: J1.20 (Dp1), J1.22 (Dp2), U2.3 (I/O2), U2.4 (I/O2), U20.46 (PA12)
USB_SHIELD: C5.1, J1.13 (EH1), J1.14 (EH2), J1.27 (EH3), J1.28 (EH4), R2.1
UVLO_P: R12.2, R13.1, U7.14 (EN/UVLO/SYNC)
V3V3: C15.1, C50.1, C51.1, C69.1, C70.1, C93.1, C94.1, C96.1, C113.1, C114.1, C115.1, C116.1, C117.1, FB2.1, J2.9 (LEDG_A), J2.12 (LEDY_A), J5.9, J6.1, R22.1, R50.1, R52.1, R53.1, R54.1, R60.1, R61.1, R78.1, R108.1, R113.1, R120.1, R121.1, SW2.2 (CD), U2.5 (VBUS), U4.5 (VOUT), U20.1 (VBAT), U20.16 (VDD), U20.28 (VREF+), U20.29 (VDDA), U20.32 (VDD), U20.48 (VDD), U20.64 (VDD), U21.28 (VDD), U34.20 (DVDD), X1.1 (Tri-State), X1.4 (VDD)
V3V3A: C18.1, C19.1, C80.1, C81.1, C91.1, C92.1, U5.5 (V_{OUT}), U30.5 (CLR#), U30.9 (AVDD), U34.1 (AVDD)
V3V3_ETH: C62.1, C63.1, C64.1, C65.1, C66.1, C67.1, C68.1, FB2.2, R71.1, R72.1, R73.1, U21.4 (AVDD), U21.8 (AVDD), U21.11 (AVDD), U21.15 (AVDD), U21.17 (AVDD), U21.21 (AVDD)
V5: C12.1, C13.1, C14.1, D42.1 (cathode), D44.1 (cathode), FB1.1, J4.1, J5.1, J5.2, K1.1, L1.2, R5.1, U4.1 (VIN), U4.3 (EN)
V5A: C16.1, C17.1, C21.1, C83.1, C87.1, C89.1, FB1.2, U5.1 (V_{IN}), U5.3 (CE), U6.1 (VIN), U6.6 (EN), U31.8 (VDD), U32.8 (VDD), U33.7 (+VS)
VBUS: C1.1, C4.1, J1.16 (VBUS1), J1.25 (VBUS2), Q1.1 (S), Q1.2 (S), Q1.3 (S), R1.1, R3.1, U1.24 (VDD)
VI: R80.1, R84.1, R97.1, U33.6 (OUT)
VIN: C6.1, C7.1, C8.1, C9.1, C10.1, C29.1, C30.1, C37.1, C38.1, C39.1, D1.1 (C), L2.1, Q1.5 (D), Q1.6 (D), Q1.7 (D), Q1.8 (D), R4.1, R12.1, R18.1, R55.1, U3.3 (VIN), U7.1 (BIAS), U8.3 (VIN)
VIN_MON: C53.1, R55.2, R56.1, U20.12 (PA0)
VN: C37.2, C38.2, C39.2, C40.2, C41.2, C42.2, C102.2, C103.2, C105.2, D41.2 (anode), R19.2, R21.2, R59.1, R109.2, U8.4 (GND), U40.4 (V-), U41.3
VNA: C23.2, C84.2, C88.2, C90.2, R7.1, U6.4 (VOUT), U31.4 (VSS), U32.4 (VSS), U33.4 (-VS)
VNA_FB: R7.2, R8.1, U6.5 (VFB)
VN_CTL: C43.1, Q3.1 (B), R23.2
VN_MON: C55.1, R59.2, R60.2, U20.14 (PA2)
VP: C26.1, C27.1, C28.1, C100.1, C101.1, D2.1 (cathode), D3.3 (K), D40.1 (cathode), R14.1, R57.1, U40.5 (V+)
VP_CTL: C35.1, R16.1, R17.2
VP_MON: C54.1, R57.2, R58.1, U20.13 (PA1)
VSET: R100.1, R101.1, U30.1 (VOUTA)
XI: C60.1, U21.30 (XI/CLKIN), Y1.1
XO: C61.1, U21.31 (XO), Y1.3

Notes on the sheet:
USB-C PD input
logic supplies
V+ rail: SEPIC
V- rail: inverting buck-boost
MCU
Ethernet
analog control & measurement
output stage
fan, front panel

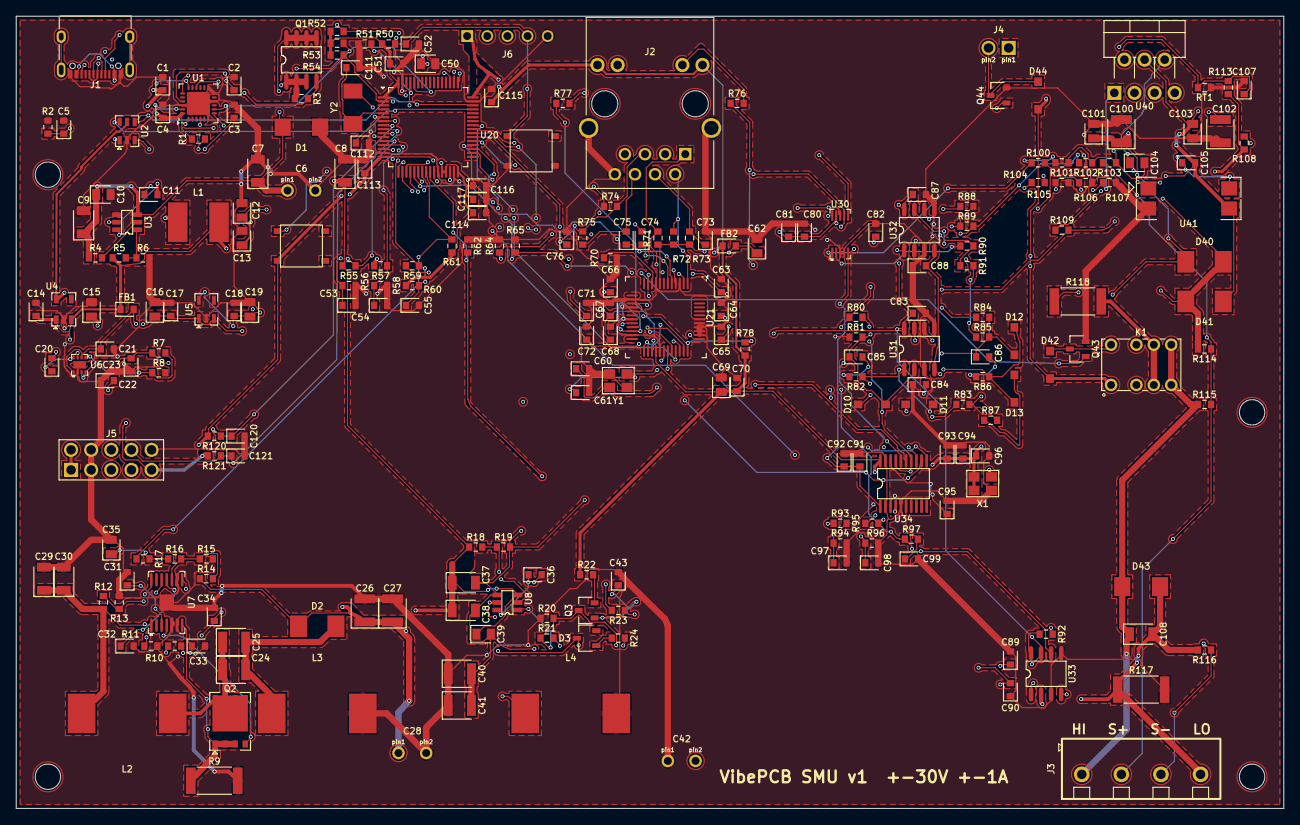
[picture p17: board smu-main.kicad_pcb from above]

Board: 4 copper layers, 160.0 x 100.0 mm, 240 parts (0 on the bottom side), 134 nets.
