PaulBichl/vibepcb-smu/boards/smu-front/hardware/kicad/smu-front.kicad_pcb

## KiCad design boards/smu-front/hardware/kicad/smu-front.kicad_pcb (2026-10-14)

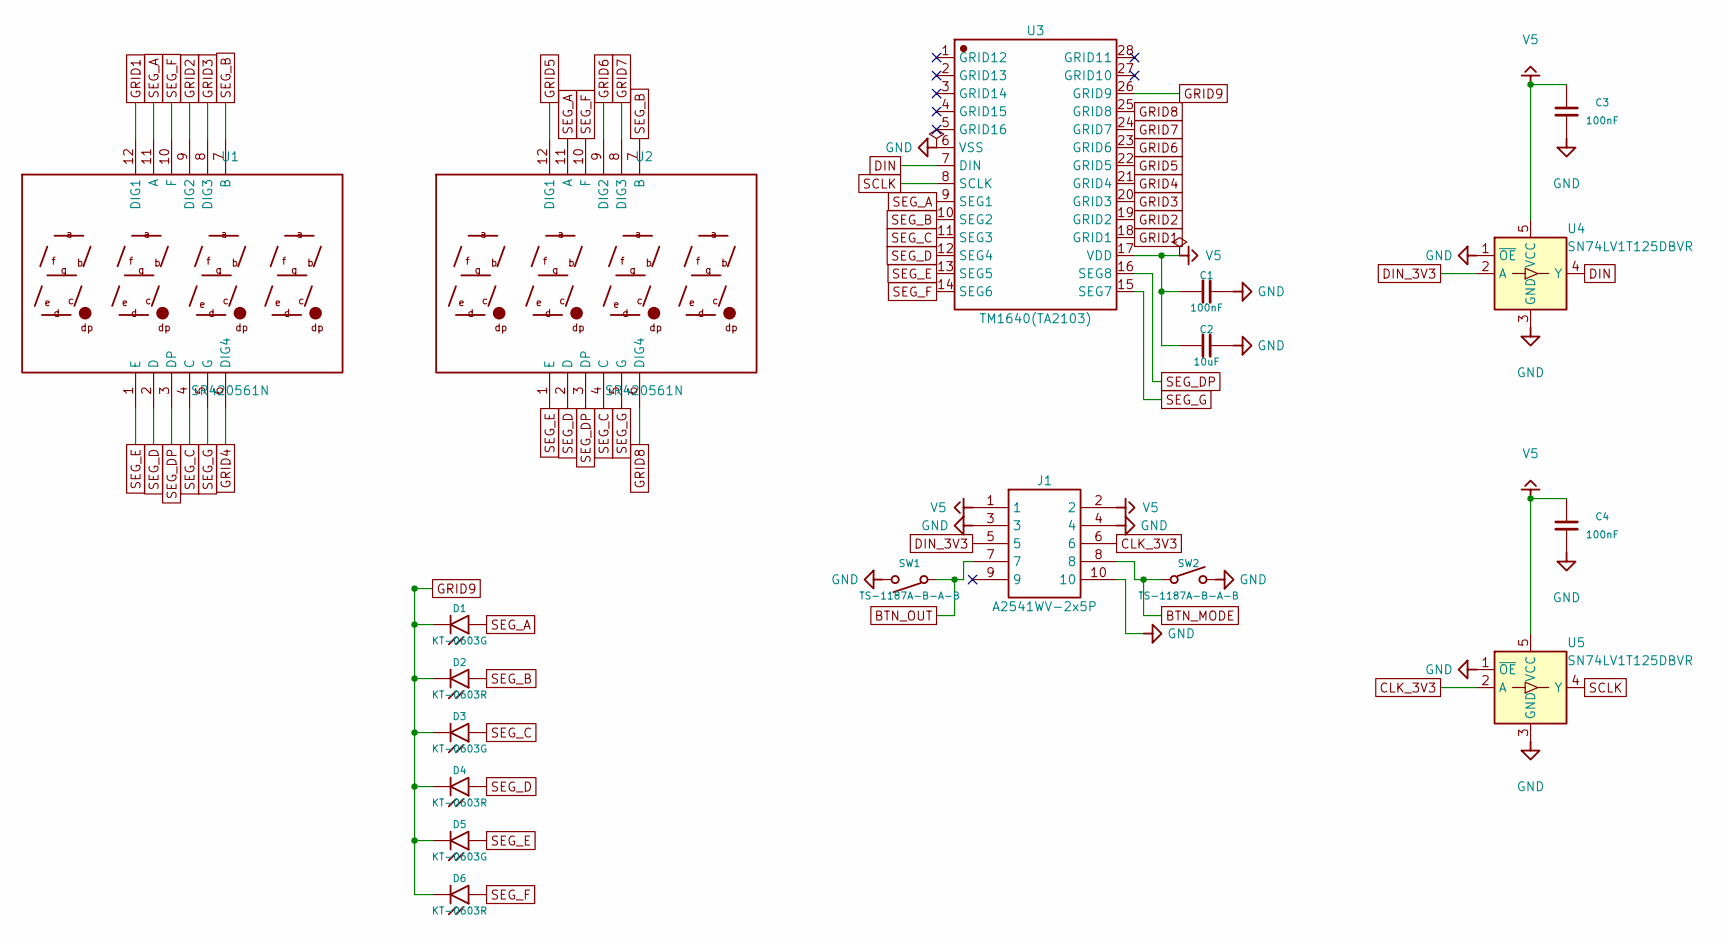
[picture p18: schematic smu-front.kicad_sch]

Parts:
C1, C3, C4: 100nF; capacitor_cap0603; LCSC C14663
C2: 10uF; capacitor_cap0805; LCSC C15850
D1, D3, D5: KT-0603G; MPN KT-0603G; LCSC C12624
D2, D4, D6: KT-0603R; MPN KT-0603R; LCSC C2286
J1: A2541WV-2x5P; MPN A2541WV-2x5P; LCSC C225520
SW1, SW2: TS-1187A-B-A-B; MPN TS-1187A-B-A-B; LCSC C318884
U1, U2: SR420561N; MPN SR420561N; LCSC C109200
U3: TM1640(TA2103); TM1640_TA2103; MPN TM1640(TA2103); LCSC C5337152
U4, U5: SN74LV1T125DBVR; MPN SN74LV1T125DBVR; LCSC C473338

Connections:
BTN_MODE: J1.8, SW2.1 (AB)
BTN_OUT: J1.7, SW1.1 (AB)
CLK_3V3: J1.6, U5.2 (A)
DIN: U3.7 (DIN), U4.4 (Y)
DIN_3V3: J1.5, U4.2 (A)
GND: C1.2, C2.2, C3.2, C4.2, J1.3, J1.4, J1.10, SW1.2 (CD), SW2.2 (CD), U3.6 (VSS), U4.1 (~OE), U4.3 (GND), U5.1 (~OE), U5.3 (GND)
GRID1: U1.12 (DIG1), U3.18 (GRID1)
GRID2: U1.9 (DIG2), U3.19 (GRID2)
GRID3: U1.8 (DIG3), U3.20 (GRID3)
GRID4: U1.6 (DIG4), U3.21 (GRID4)
GRID5: U2.12 (DIG1), U3.22 (GRID5)
GRID6: U2.9 (DIG2), U3.23 (GRID6)
GRID7: U2.8 (DIG3), U3.24 (GRID7)
GRID8: U2.6 (DIG4), U3.25 (GRID8)
GRID9: D1.1 (cathode), D2.2 (cathode), D3.1 (cathode), D4.2 (cathode), D5.1 (cathode), D6.2 (cathode), U3.26 (GRID9)
SCLK: U3.8 (SCLK), U5.4 (Y)
SEG_A: D1.2 (anode), U1.11 (A), U2.11 (A), U3.9 (SEG1)
SEG_B: D2.1 (anode), U1.7 (B), U2.7 (B), U3.10 (SEG2)
SEG_C: D3.2 (anode), U1.4 (C), U2.4 (C), U3.11 (SEG3)
SEG_D: D4.1 (anode), U1.2 (D), U2.2 (D), U3.12 (SEG4)
SEG_DP: U1.3 (DP), U2.3 (DP), U3.16 (SEG8)
SEG_E: D5.2 (anode), U1.1 (E), U2.1 (E), U3.13 (SEG5)
SEG_F: D6.1 (anode), U1.10 (F), U2.10 (F), U3.14 (SEG6)
SEG_G: U1.5 (G), U2.5 (G), U3.15 (SEG7)
V5: C1.1, C2.1, C3.1, C4.1, J1.1, J1.2, U3.17 (VDD), U4.5 (VCC), U5.5 (VCC)

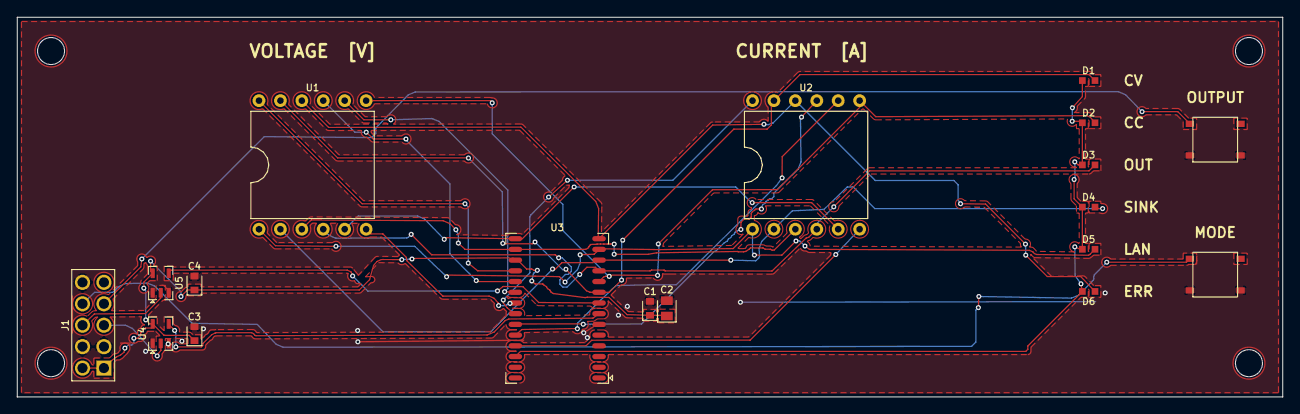
[picture p19: board smu-front.kicad_pcb from above]

Board: 2 copper layers, 150.0 x 45.0 mm, 18 parts (0 on the bottom side), 25 nets.
