PaulBichl/vibepcb-smu/(commit log)

2026-10-12 SMU: main board (4 layers, routed) and front display board
    - smu-main: 238 parts placed without errors, fully routed by tscircuit
    (schematicDisabled: the schematic is generated from the netlist by VibePCB).
    Every trace gets maxLength (tscircuit's hidden 1 mm decoupling limit skipped
    all routing otherwise).
    - smu-front: passes VibePCB check (DRC 0 errors); fab outputs generated.
    - pyproject: run VibePCB from ../VibePCB/src (the path dependency was a frozen copy).
    Routing smu-main needs local patches to node_modules (capacity-autorouter
    0.0.958 duplicate-route checks, @tscircuit/core pour cleanup); originals kept
    as *.orig.
2026-10-12 smu-main: clearance 0.1 mm (what the router does; JLCPCB 4-layer allows 0.09 mm)
2026-10-13 Both boards: a pour on every copper layer (GND; smu-main In2 too)
2026-10-13 smu-main: no top-layer routing under the ESP32 module (keepout inside its pad ring)
    The router used the module's underside as a channel and dropped vias between
    its pads (shorts, hole clearance).
2026-10-13 smu-main: R51/C51/C50 1 mm further from the ESP32 (fan-out room)
2026-10-13 smu-main: U30 0.5 mm down (via fan-out)
2026-10-14 smu-main: STM32G431 replaces ESP32; pins assigned by package side; fixed OPA548 ILIM; imported symbols stripped
2026-10-14 smu: 0.3/0.5 mm vias, in-stock LMR51635Y buck, SWD header part, front displays upright, silkscreen clear of C42
2026-10-14 smu-main: R118 0.47 R isolates the OPA548 from the output capacitance (oscillated into 1 uF with TI's model); sim: vendor-model loop + perf suite, README performance estimates
2026-10-14 Review set for GitHub: schematic, layout, 3D renders, BOM and KiCad project of both boards (pcb publish); README: Look at it
    [smu-front-bom.csv, smu-front.kicad_pcb, smu-front.kicad_sch, smu-main-bom.csv, smu-main.kicad_pcb, smu-main.kicad_sch]
